iamdamith21/OfficeMate-Autonomous-Navigation-System/src/robot_description/docs/wiring_diagram_v3.png

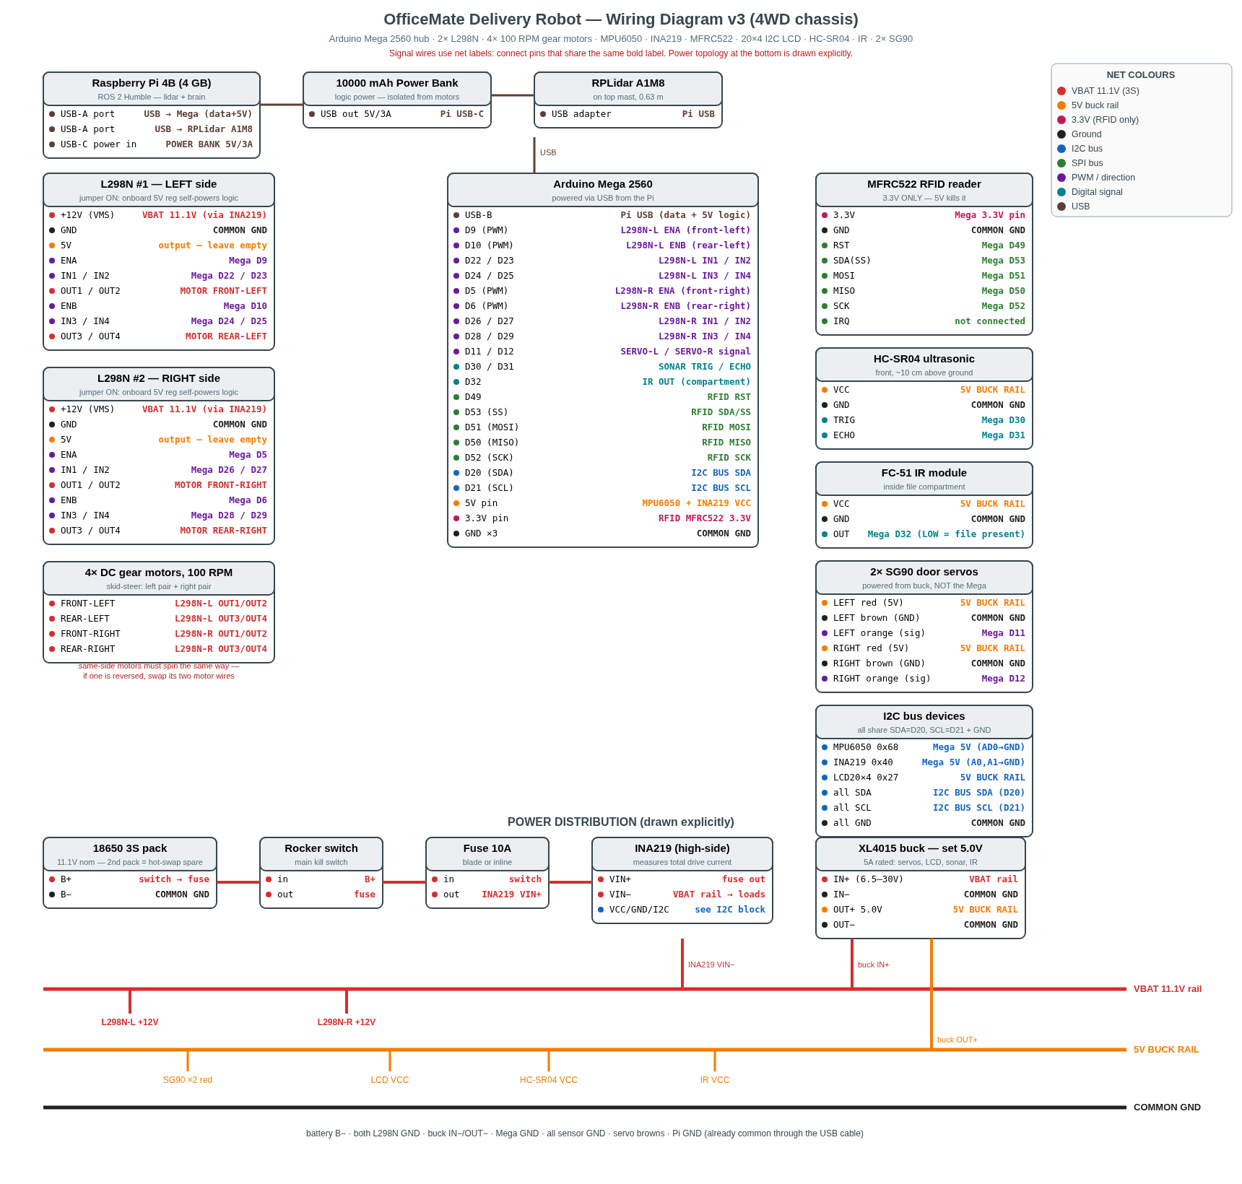
src/robot_description/docs/wiring_diagram_v3.png
