iamdamith21/OfficeMate-Autonomous-Navigation-System/(commit log)

2026-07-04 Working state before re-architecture: LTME-02A mapping, 4WD URDF, SLAM fixes
    - ltme_node ROS2 port (best-effort scan QoS, no-return=0 not inf)
    - 4WD skid-steer URDF, fixed laser_joint
    - ekf predict_to_current_time, cyclonedds wifi pinning
    [base.xacro, caster_wheel.xacro, drive_wheel.xacro, imu.xacro, inertials.xacro, lidar.xacro, materials.xacro, properties.xacro]
2026-07-04 Fold driver packages into monorepo (was submodule gitlinks)
2026-07-04 Phase 1: redesign robot model to match real robot
    - Tiered enclosure: grey file compartment + split double-doors (revolute),
    open middle (4 posts + shelf), black top deck carrying lidar + blue RFID
    - Ultrasonic modelled as grey HC-SR04 twin-transducer eyes
    - IMU centred on base_link; lower ground clearance; correct color palette
    [base.xacro, imu.xacro, lidar.xacro, materials.xacro, properties.xacro, rfid.xacro, robot.urdf.xacro, ultrasonic.xacro]
2026-07-04 Phase 1 revision: black bottom box, grey split-door compartment (middle), black deck; RFID centred; HC-SR04 look; minimal TF (structural geometry merged onto base_link)
    [base.xacro, lidar.xacro, materials.xacro, properties.xacro, rfid.xacro, robot.urdf.xacro, ultrasonic.xacro]
2026-07-04 Phase 3: tune SLAM (Huber-loss pose-graph, strict loop closure, leaner graph) + EKF (rf2o vx-only, gyro yaw-rate) for 270deg LTME
2026-07-05 Model revision 2: black full enclosure (bottom), grey corner bars, smaller raised grey file compartment with split doors, black deck; silver wheel hubs
    [base.xacro, drive_wheel.xacro, materials.xacro, properties.xacro]
2026-07-05 Phase 4: re-architect into 8 packages
    robot_description, robot_bringup, robot_mapping, robot_navigation,
    robot_interfaces (msg/srv/action), hardware_bridge, mission_manager,
    web_bridge. Drivers (ltme_node, sllidar_ros2, rf2o) kept. All launch refs
    rewired; full colcon build green; mapping verified end-to-end in new layout.
    [base.xacro, caster_wheel.xacro, drive_wheel.xacro, imu.xacro, inertials.xacro, lidar.xacro, materials.xacro, properties.xacro]
2026-07-05 Phase 5: delivery mission state machine
    delivery_manager FSM (INITIALIZING..IDLE per spec) as a DeliveryMission action
    server; publishes /mission_state each transition; wired to Nav2 NavigateToPose +
    hardware_bridge (/rfid/tag, /doors/open|close, /compartment/occupied IR).
    simulate mode; verified full mission cycle end-to-end.
2026-07-05 Fix: restore rf2o yaw-rate in EKF (robot rotates again, not just fwd/back); RFID box -> 6x3x1 cm
    [properties.xacro]
2026-07-07 Remove sllidar (LTME-only), split firmware into robot_firmware pkg, add README + gitignore
    - Drop unused sllidar_ros2 driver and its rplidar-only reset dance;
    bringup/mapping launches are now LTME-02A-only (removed the lidar arg,
    reset_lidar.py, and the sllidar exec_depend).
    - New robot_firmware ament_cmake package holds the Arduino sketch and
    flash_firmware.sh (moved out of hardware_bridge, history preserved).
    - Add a professional root README documenting the project, hardware,
    package layout, and build/run flow.
    - Expand .gitignore (colcon, python, arduino, editor, OS artifacts).
    [robot_firmware.ino]
2026-07-27 Fit MPU6500 IMU + HC-SR04 sonar, and tune navigation for smooth turning
    Firmware v10 adds both sensors to the motors-only v9 build, without
    disturbing the software-PWM motor loop: the sonar is a non-blocking state
    machine (pulseIn would stall the loop for five PWM periods) and IMU lines are
    dropped rather than allowed to block on a full UART buffer.
    Three hardware quirks found by measurement, all documented at the point of
    the workaround:
    - the MPU clone NAKs its address after a few ms idle but is solid when read
    back-to-back, so reads retry immediately instead of delaying or resetting
    the bus (both of which made it worse)
    - it requires a repeated start; a STOP between register write an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
    [api_adapter.py, arduino_bridge.py, robot_firmware.ino]
2026-07-27 web_bridge: run rosbridge service calls and action goals off the main thread
    DeliveryMission is long-running; with the Humble defaults, dispatching it
    blocks rosbridge main loop and freezes telemetry for the whole mission --
    the dashboard would read offline exactly while the robot was busy.
2026-07-27 Fix two nav regressions and rescale the pivot gain from measurement
    TURN_GAIN_PIVOT 8.0 -> 6.5. The theoretical 8.0 restored the proportional
    band but over-rotated at the top (0.50 commanded -> 0.651 achieved, ratio
    1.30). Measured with turntest.py using the gyro as ground truth, 6.5 gives
    0.86-1.02 across 0.15-0.45 rad/s. The angular ceiling is now 0.45 rather than
    0.50 for the same reason: the response stays honest to 0.45 and then runs
    away, and Nav2's controllers assume commanded ~= achieved.
    range_layer no_readings_timeout 2.0 -> 0.0. This one was mine and it silently
    broke navigation: a non-zero timeout makes RangeSensorLayer mark itself not
    current whenever the sonar pauses, which ma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
    [robot_firmware.ino]
2026-07-27 Version the diagnostic tools that were only on the Pi
    turntest.py, navgoal.py, freespace.py, navctl.sh and friends lived in
    ~/officemate_tools and ~/fw_testing -- nowhere backed up -- yet they encode
    measurements and workarounds that were expensive to rediscover. README records
    the three traps they exist to avoid: pkill matching your own ssh session, the
    ros2 daemon silently reporting zero nodes on an RMW mismatch, and reading the
    costmap OccupancyGrid with raw 0-255 thresholds when it is scaled 0-100.
    [calibrate.py, checkloc.py, freespace.py, globalloc.py, navgoal.py, sensor_check.py, turntest.py]
2026-07-27 Firmware v10.1: INA219 power monitoring and a non-blocking 20x4 LCD
    The LCD driver is written from scratch rather than using LiquidCrystal_I2C.
    That library writes a whole line in one blocking call -- several milliseconds,
    most of a 6 ms software-PWM period -- so the motors would stutter on every
    refresh. This keeps a shadow buffer, diffs it against the target and pushes
    exactly ONE changed character per 3 ms tick, so the longest blocking I2C burst
    is a single character (~135 us). Full repaint ~240 ms; a typical digit update
    far less.
    INA219 emits B,<volts>,<amps> at 1 Hz, which arduino_bridge already parses
    into /battery/state and api_adapter already converts to /battery_level percent
    for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
2026-07-31 Rewrite the delivery FSM as an 18-state two-leg mission, add location_manager
    The FSM was a 13-state single-leg design that only did the drop-off: the
    "pickup" pose was really just the return-home target, so the robot could never
    collect a file from a sender. It is now the two-leg mission the project
    actually needs: base -> sender (load) -> recipient (unload) -> base.
    Implemented as a state-dispatch loop (_HANDLERS maps state -> handler returning
    the NEXT state) rather than a straight-line script. That is what makes a clean
    cancel possible: every transition funnels through one place, so a cancel closes
    the compartment and reroutes to RETURN_TO_BASE instead of aborting mid-step
    with the door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
2026-07-31 Version the launchers and operator tools, rewrite the README as a setup guide
    The README described the system but could not be followed to a working robot,
    because the things you actually run were not in the repository. All eleven
    launcher scripts lived only in ~/fw_testing/ on the Pi, and sixteen of the
    tools only in ~/officemate_tools/ -- including every one the current workflow
    depends on (navto.py, loccost.py, loc.py, drive.py, pickgoal.py, deliver.py).
    A setup guide that references files the reader cannot obtain is not a setup
    guide, so they are versioned here first.
    ~/fw_testing/*.sh are now symlinks into launchers/, so the two copies cannot
    drift. Logs still live in ~/fw_testing/, an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
    [deliver.py, drive.py, goto.py, loc.py, loccost.py, navtest.py, navto.py, pickgoal.py]
2026-07-31 Add nudge_locations: relocate saved poses onto ground Nav2 will enter
    The delivery FSM navigates to the STORED pose and has no snapping of its own,
    so a location recorded against a wall failed every leg that targeted it: three
    nav retries then MISSION_FAILED, with nothing in the log naming the goal as the
    cause. Two of the three surveyed locations were in that state (cost 99 and 86),
    which made a web-triggered delivery impossible.
    Requires a clear DISC around the candidate, not merely a cost-0 cell. RPP
    projects the footprint forward along the path, so a single free cell wedged
    against a wall still trips "collision ahead" on the final approach; the disc
    also leaves the arriving robot room t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
    [nudge_locations.py]
2026-07-31 Re-enable the left door servo, with a probe sketch to verify it safely first
    The left servo was replaced. Enabling it is one define, but three servos have
    already been destroyed on this robot by commanding a new or wrongly-believed
    position, so it was verified before being trusted rather than after.
    tools/left_servo_probe drives ONLY D44, so the one known-good right servo cannot
    be disturbed and two SG90s can never stall together (~700 mA each browns out the
    shared 5 V rail). Its setup() touches nothing, and its first attach targets
    90 deg -- identical to Servo::attach()'s own 1500 us default -- so the horn
    cannot lunge while its true orientation is still unknown. Everything else is
    eased o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
    [left_servo_probe.ino, robot_firmware.ino, servo_drive.py]
2026-07-31 Add rfid_check: one command to tell an MFRC522 power fault from a dead reader
    The reader polls correctly and reports present=1, yet cannot read a card, so
    "is the RFID working" needs numbers rather than tapping and hoping. This
    captures raw serial for a measured window (catching R,<UID> directly, without
    needing ROS up) and then reads the firmware counters.
    The counters are read AFTER the idle window, not immediately: closing the serial
    port resets the Mega and zeroes them, so the figure only means anything as
    drops-per-window.
    Baseline measured on the broken rail, for comparison: TxControl drops 218,
    TReload 0/0 when it wants 0/1000, VersionReg unstable 5/20, no tags. TReload
    reading back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
2026-07-31 Fix the TReload diagnostic so a healthy reader stops looking broken
    It printed a hardcoded "0/" and then the whole 16-bit RFID_TIMER_TICKS, so a
    reader correctly holding 1000 ticks reported
    E,rfid TReload 3/232 want 0/1000
    which reads as a mismatch. It is not one: 3*256 + 232 = 1000. rfidConfigure
    writes the value split across TReloadRegH/L, so the want side has to be split
    the same way to be comparable.
    This mattered because TReload is THE diagnostic for the MFRC522 power fault --
    0/0 means the chip lost its config and browned out -- and it lied at exactly the
    moment the reader was being confirmed fixed.
    Not flashed yet; the running board still has the previous build, which differs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
    [robot_firmware.ino]
2026-08-01 Add the demo runbook and preflight; fix the v11 boot hang; new door angles
    PREFLIGHT AND THE REASON IT EXISTS. launchers/preflight.sh checks, in order of
    how badly each ruins a demonstration: lidar link, Arduino port, stale nodes,
    CPU, firmware banner, and the motor rail UNDER LOAD. That last check found the
    fault that has been blamed on navigation tuning for days:
    idle 11.99 V -> under load 8.66 V (sag 3.32 V)
    Reproduced three times. turntest.py measures 0.000 rad/s achieved at every
    commanded rate from 0.15 to 0.50 with the gyro as ground truth, while the
    firmware correctly emits symmetric pwmL=-207 pwmR=207 for ang=0.45 -- exactly
    what the mixing model predicts. So the motors draw hea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
    [robot_firmware.ino]
2026-08-01 Stop a wedged I2C bus hanging a COLD boot
    The S,BOOT markers added earlier paid for themselves: boot stopped dead at
    "S,BOOT,imu", which localised the hang to the I2C init block instead of it
    presenting as a bricked board. It only reproduces on a COLD boot -- a Pi reboot
    power-cycles the Mega -- which is why the previous fix, tested on a warm reset,
    looked complete.
    Two changes:
    i2cUnwedgeBus() returned early whenever SDA happened to read high. A slave can
    be mid-transaction without holding SDA low at the instant we sample it, so the
    nine recovery clocks are now unconditional. They are harmless on an idle bus: no
    START is issued, so nothing can mistake them for addressing.
    A Wire timeout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
    [robot_firmware.ino]
2026-08-01 Drop the IMU from the EKF: laser odometry alone actually navigates
    The user was right. Fusing the MPU6500 gyro was breaking navigation, not
    improving it. Same map, same tuning, same robot, back to back:
    with IMU laser odometry only
    navigate to a goal ABORTED SUCCEEDED in 59.6 s
    position error n/a 0.150 m
    heading error n/a -7.6 deg
    checkloc after 26.7% BAD 74.6% GOOD
    checkloc before 81.2% -> 26.7% 88.3% -> 74.6%
    The tell was AMCL decaying from 81% to 27% while the robot stood still. A pose
    that rots without motion is being corrupted by odometry, and the gyro was the
    only yaw source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
2026-08-04 Update navigation stack, single-loop SLAM, 85mm 4WD model, save_location tool, and API adapter
    [properties.xacro]
